jakobfaltisek/electronic-load-power-meter/README.md

View this project on [CADLAB.io](https://cadlab.io/project/1274). 

# electronic-load-power-meter
