jakobfaltisek/electronic-load-power-meter/PCB/eload_powermeter.brd

## EAGLE design PCB/eload_powermeter.brd (2018-08-28)

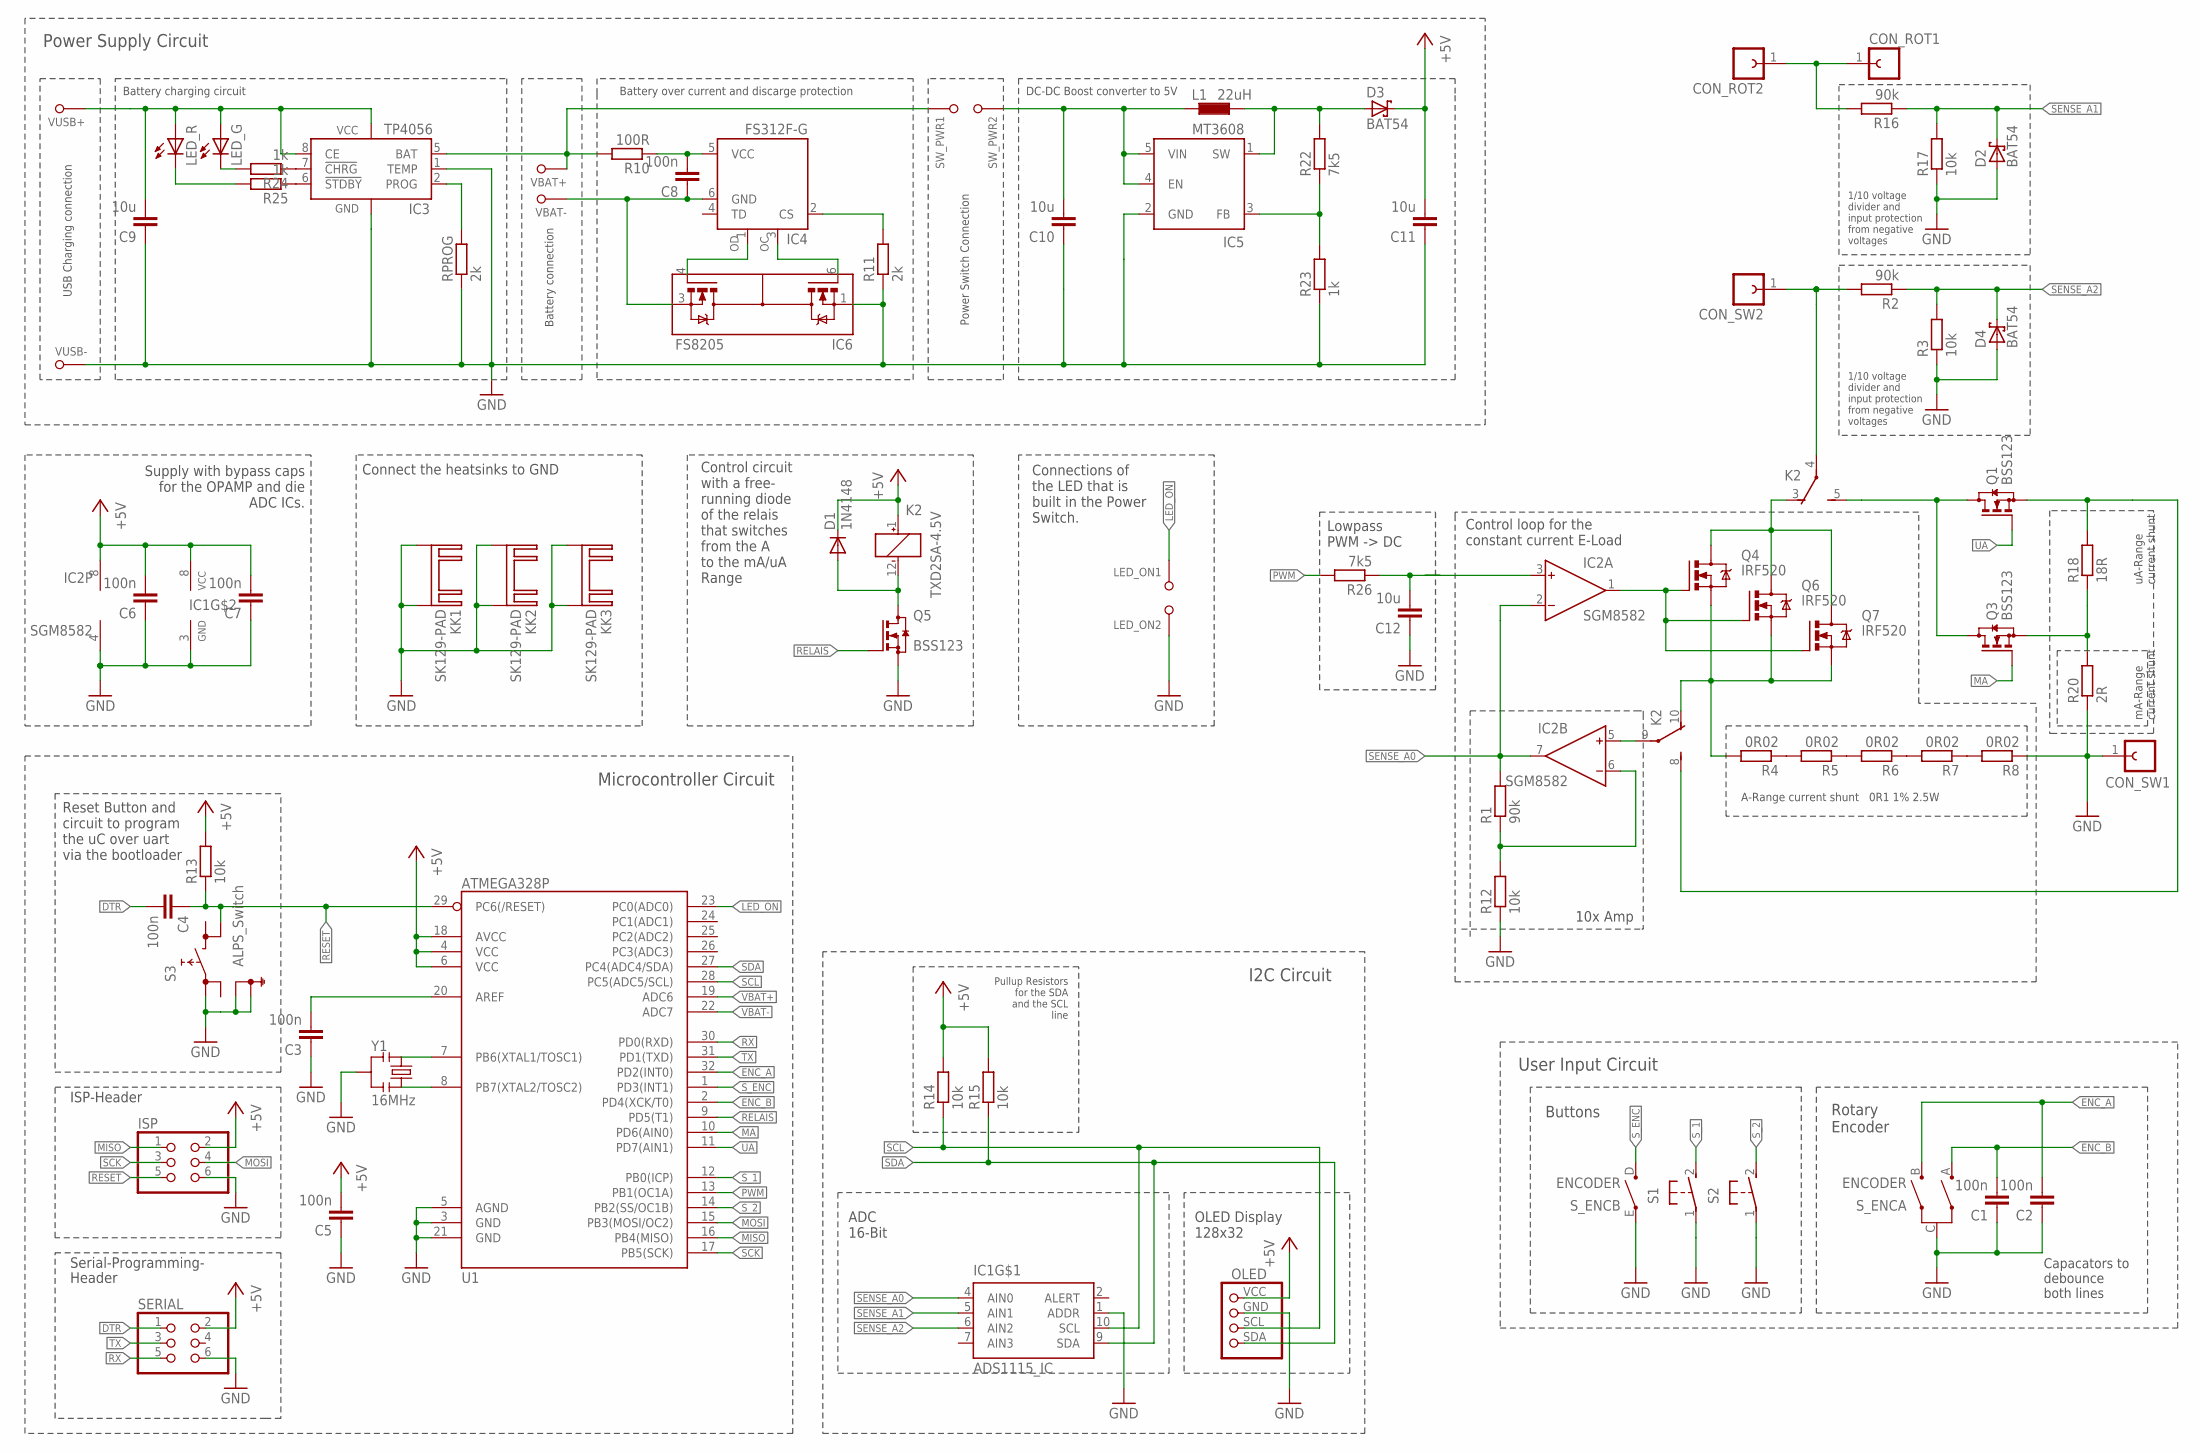
[picture p1: schematic eload_powermeter.sch]

Parts:
C1, C2, C3, C4, C5, C6, C7, C8: 100n; C0603
C9, C10, C11, C12: 10u; C0603
CON_ROT1, CON_ROT2: BANANEN_BUCHSE; BANANENBUCHSE
CON_SW1, CON_SW2: BANANEN_BUCHSE; BANANENBUCHSE
D1: 1N4148; SOD123
D2, D3, D4: BAT54; SOT23
IC1: ADS1115_IC; MSOP10
IC2: SGM8582; SO8
IC3: TP4056; SOP08
IC4: FS312F-G; SOT23-6
IC5: MT3608; SOT23-6
IC6: FS8205; SOT23-6
ISP: PINHD-2X3_SMD; 2X03
K2: TXD2SA-4.5V; TXD2SA
KK1, KK2, KK3: SK129-PAD; SK129
L1: 22uH; R1210
LED_G: LED_REVERSE_MOUNTSMT1206_REVERSE; 1206_LED_REVERSE_MOUNT
LED_ON1, LED_ON2: SOLDER_PAD
LED_R: LED_REVERSE_MOUNTSMT1206_REVERSE; 1206_LED_REVERSE_MOUNT
OLED: OLED_128X32; 1X04_OLED
Q1, Q3, Q5: BSS123; SOT23
Q4, Q6, Q7: IRF520; TO220BV
R1, R2, R16: 90k; R0603
R3, R12, R13, R14, R15, R17: 10k; R0603
R4, R5, R6, R7, R8: 0R02; R1206
R10: 100R; R0603
R11: 2k; R0603
R18: 18R; R0603
R20: 2R; R0603
R22, R26: 7k5; R0603
R23, R24, R25: 1k; R0603
RPROG: 2k; R0603
S1, S2: PUSH_BUTTON_ALPS; B3F-31XX
S3: ALPS_Switch; SKHMPXE010
SERIAL: PINHD-2X3_SMD; 2X03
SW_PWR1, SW_PWR2: SOLDER_PAD
S_ENC: ENCODER; CI-11
U1: ATMEGA328P; TQFP32-08
VBAT+: SOLDER_PAD
VBAT-: SOLDER_PAD
VUSB+: SOLDER_PAD
VUSB-: SOLDER_PAD
Y1: 16MHz; RESONATOR-SMD-1:1

Connections:
+5V: C5.2, C6.2, C7.2, C11.2, D1.C, D3.3 (C), IC1.8 (VCC), IC2.8 (V+), ISP.2, K2.1 (+), OLED.VCC (VDD), R13.2, R14.2, R15.2, SERIAL.2, U1.4 (VCC), U1.6 (VCC), U1.18 (AVCC)
DTR: C4.2, SERIAL.1
ENC_A: C2.2, S_ENC.B, U1.32 (PD2(INT0))
ENC_B: C1.2, S_ENC.A, U1.2 (PD4(XCK/T0))
GND: C1.1, C2.1, C3.1, C5.1, C6.1, C7.1, C9.1, C10.1, C11.1, C12.1, CON_SW1.1, D2.1 (A), D4.1 (A), IC1.1 (ADDR), IC1.3 (GND), IC2.4 (V-), IC3.1 (TEMP), IC3.3 (GND), IC5.2 (GND), IC6.1 (S1), ISP.6, KK1.A2,5, KK1.B2,5, KK2.A2,5, KK2.B2,5, KK3.A2,5, KK3.B2,5, LED_ON2.P$1, OLED.GND, Q5.2 (S), R3.1, R8.1, R11.1, R12.1, R17.1, R20.1, R23.1, RPROG.1, S1.1, S2.1, S3.1 (3.1), S3.5 (SH1), S3.6 (SH2), SERIAL.6, S_ENC.C, S_ENC.E, U1.3 (GND), U1.5 (AGND), U1.21 (GND), VUSB-.P$1, Y1.2
LED_ON: LED_ON1.P$1, U1.23 (PC0(ADC0))
MA: Q3.1 (G), U1.10 (PD6(AIN0))
MISO: ISP.1, U1.16 (PB4(MISO))
MOSI: ISP.4, U1.15 (PB3(MOSI/OC2))
unnamed: CON_ROT1.1, CON_ROT2.1, R16.2
unnamed: IC2.1 (OUT), Q4.G, Q6.G, Q7.G
unnamed: Q3.2 (S), R18.1, R20.2
unnamed: K2.5 (S), Q1.3 (D), Q3.3 (D)
unnamed: R4.1, R5.2
unnamed: K2.10 (O), Q4.S, Q6.S, Q7.S, R4.2
unnamed: C12.2, IC2.3 (IN+), R26.1
unnamed: K2.3 (O), Q4.D, Q6.D, Q7.D
unnamed: D1.A, K2.12 (-), Q5.3 (D)
unnamed: R5.1, R6.2
unnamed: U1.7 (PB6(XTAL1/TOSC1)), Y1.1
unnamed: IC2.5 (IN+), K2.9
unnamed: CON_SW2.1, K2.4, R2.2
unnamed: U1.8 (PB7(XTAL2/TOSC2)), Y1.3
unnamed: C8.2, IC4.5 (VCC), R10.1
unnamed: R6.1, R7.2
unnamed: R7.1, R8.2
unnamed: D3.1 (A), IC5.1 (SW), L1.2, R22.2
unnamed: IC4.1 (OD), IC6.4 (G2)
unnamed: IC3.2 (PROG), RPROG.2
unnamed: IC4.3 (OC), IC6.6 (G1)
unnamed: C10.2, IC5.4 (EN), IC5.5 (VIN), L1.1, SW_PWR2.P$1
unnamed: IC4.2 (CS), R11.2
unnamed: IC5.3 (FB), R22.1, R23.2
unnamed: IC3.7 (!CHRG), R24.1
unnamed: IC3.6 (!STDBY), R25.1
unnamed: LED_G.C, R24.2
unnamed: LED_R.C, R25.2
unnamed: C3.2, U1.20 (AREF)
unnamed: IC2.6 (IN-), R1.1, R12.2
unnamed: K2.8 (S), Q1.2 (S), R18.2
PWM: R26.2, U1.13 (PB1(OC1A))
RELAIS: Q5.1 (G), U1.9 (PD5(T1))
RESET: C4.1, ISP.5, R13.1, S3.4 (4.2), U1.29 (PC6(/RESET))
RX: SERIAL.5, U1.30 (PD0(RXD))
SCK: ISP.3, U1.17 (PB5(SCK))
SCL: IC1.10 (SCL), OLED.SCL, R14.1, U1.28 (PC5(ADC5/SCL))
SDA: IC1.9 (SDA), OLED.SDA, R15.1, U1.27 (PC4(ADC4/SDA))
SENSE_A0: IC1.4 (AIN0), IC2.2 (IN-), IC2.7 (OUT), R1.2
SENSE_A1: D2.3 (C), IC1.5 (AIN1), R16.1, R17.2
SENSE_A2: D4.3 (C), IC1.6 (AIN2), R2.1, R3.2
S_1: S1.2 (S), U1.12 (PB0(ICP))
S_2: S2.2 (S), U1.14 (PB2(SS/OC1B))
S_ENC: S_ENC.D, U1.1 (PD3(INT1))
TX: SERIAL.3, U1.31 (PD1(TXD))
UA: Q1.1 (G), U1.11 (PD7(AIN1))
VBAT+: IC3.5 (BAT), R10.2, SW_PWR1.P$1, U1.19 (ADC6), VBAT+.P$1
VBAT-: C8.1, IC4.6 (GND), IC6.3 (S2), U1.22 (ADC7), VBAT-.P$1
VUSB: C9.2, IC3.4 (VCC), IC3.8 (CE), LED_G.A, LED_R.A, VUSB+.P$1

Notes on the sheet:
Microcontroller Circuit
ISP-Header
Serial-Programming-
Header
10x Amp
Lowpass PWM -> DC
1/10 voltage divider and input protection from negative voltages
A-Range current shunt 0R1 1% 2.5W
mA-Range current shunt
uA-Range current shunt
Control loop for the constant current E-Load
Reset Button and circuit to program the uC over uart via the bootloader
Supply with bypass caps for the OPAMP and die ADC ICs.
Connect the heatsinks to GND
Control circuit with a free- running diode of the relais that switches from the A to the mA/uA Range
Battery charging circuit
Battery over current and discarge protection
DC-DC Boost converter to 5V
USB Charging connection
Battery connection
Power Switch Connection
Power Supply Circuit
I2C Circuit
Pullup Resistors for the SDA and the SCL line
ADC 16-Bit
OLED Display 128x32
Buttons
Rotary Encoder
User Input Circuit
Capacators to debounce both lines
Connections of the LED that is built in the Power Switch.

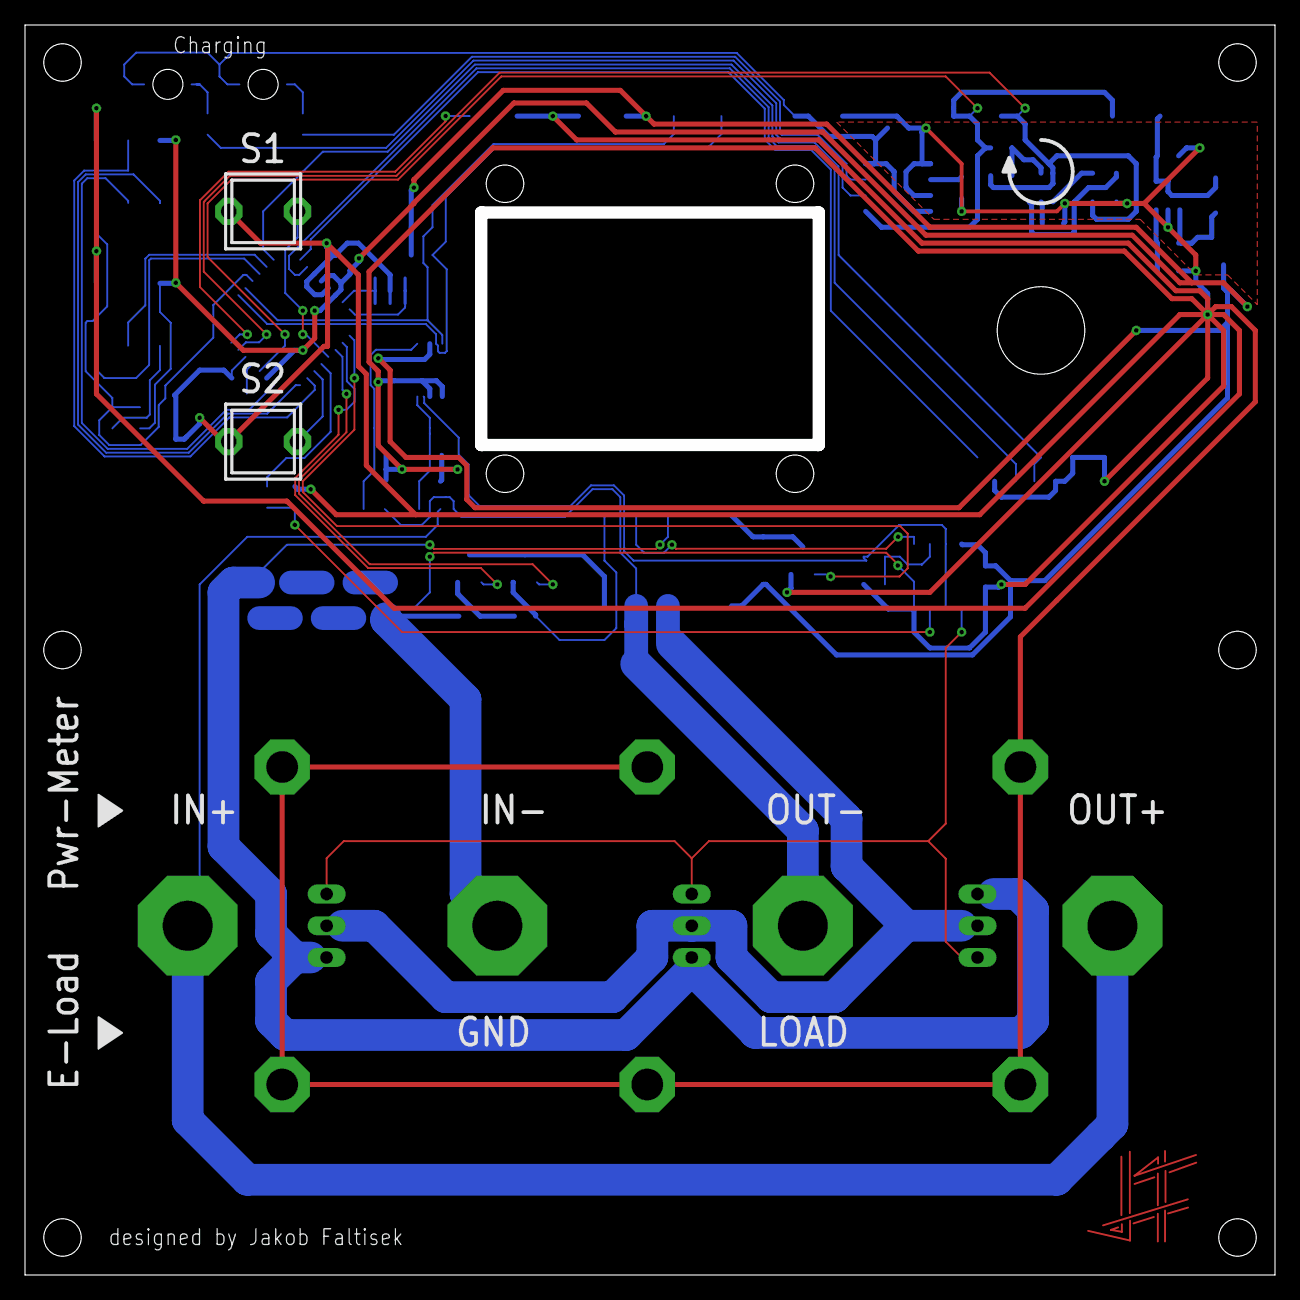
[picture p2: board eload_powermeter.brd from above]

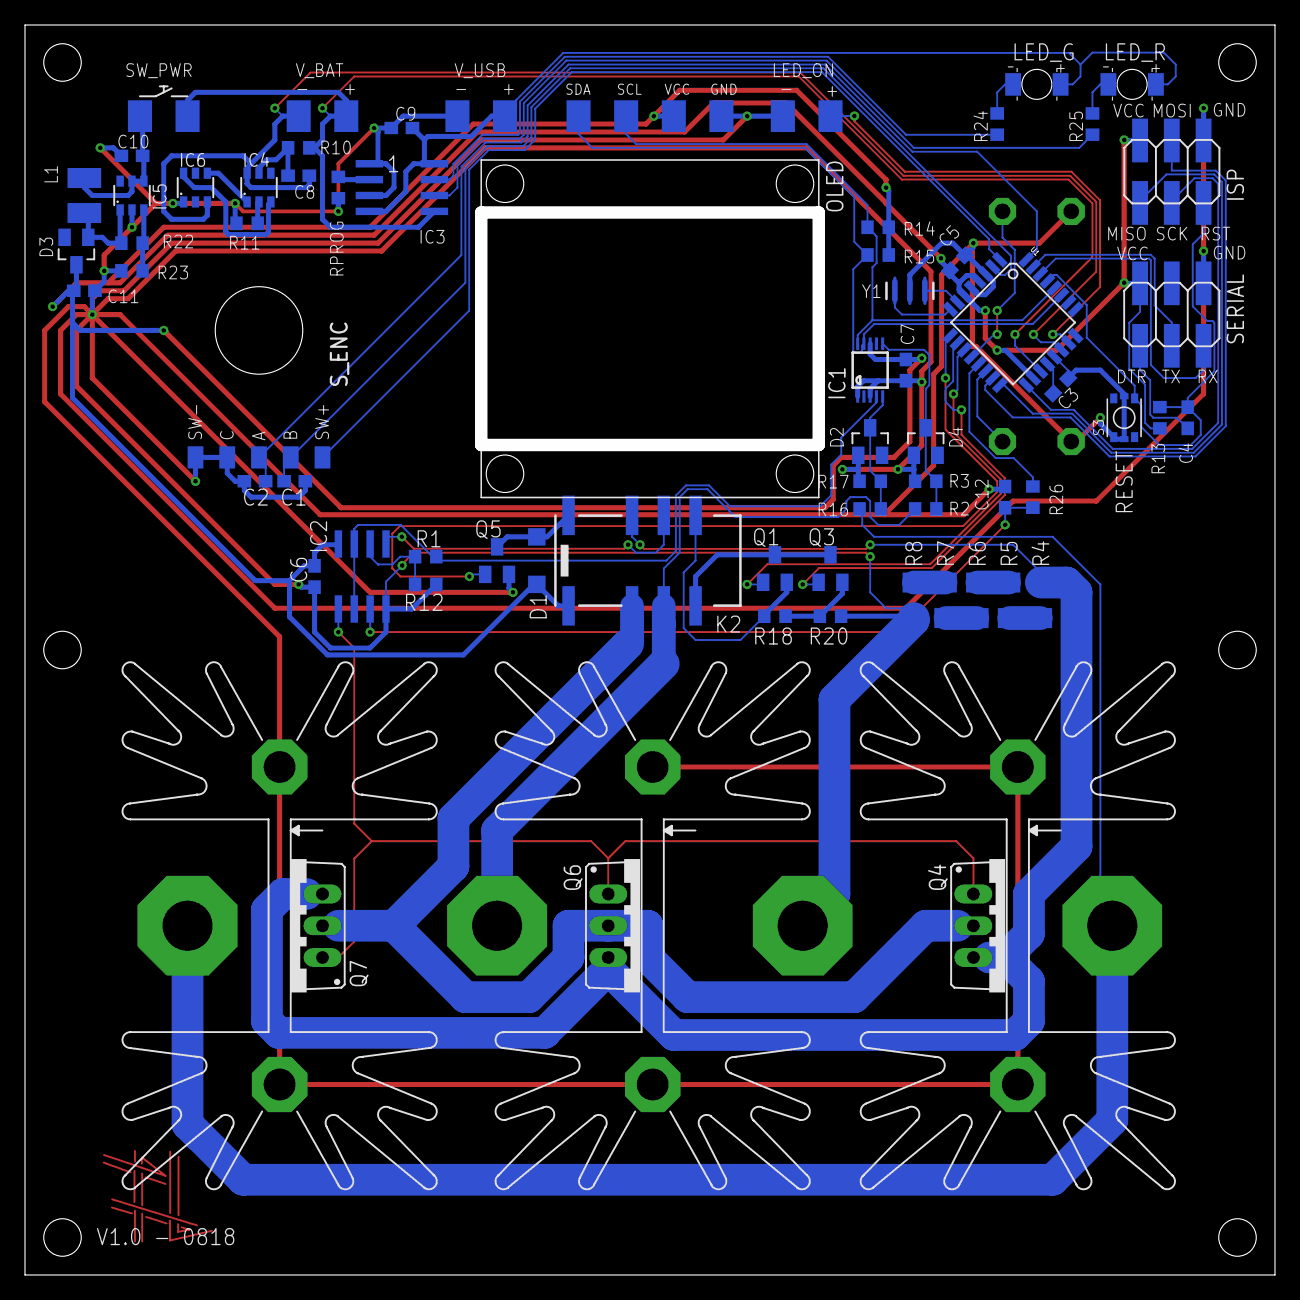
[picture p3: board eload_powermeter.brd from below]

Board: 2 copper layers, 100.0 x 100.0 mm, 80 parts (72 on the bottom side), 58 nets.
